XuNeo/stm8-led-display/hw/STM8-LED.pdf

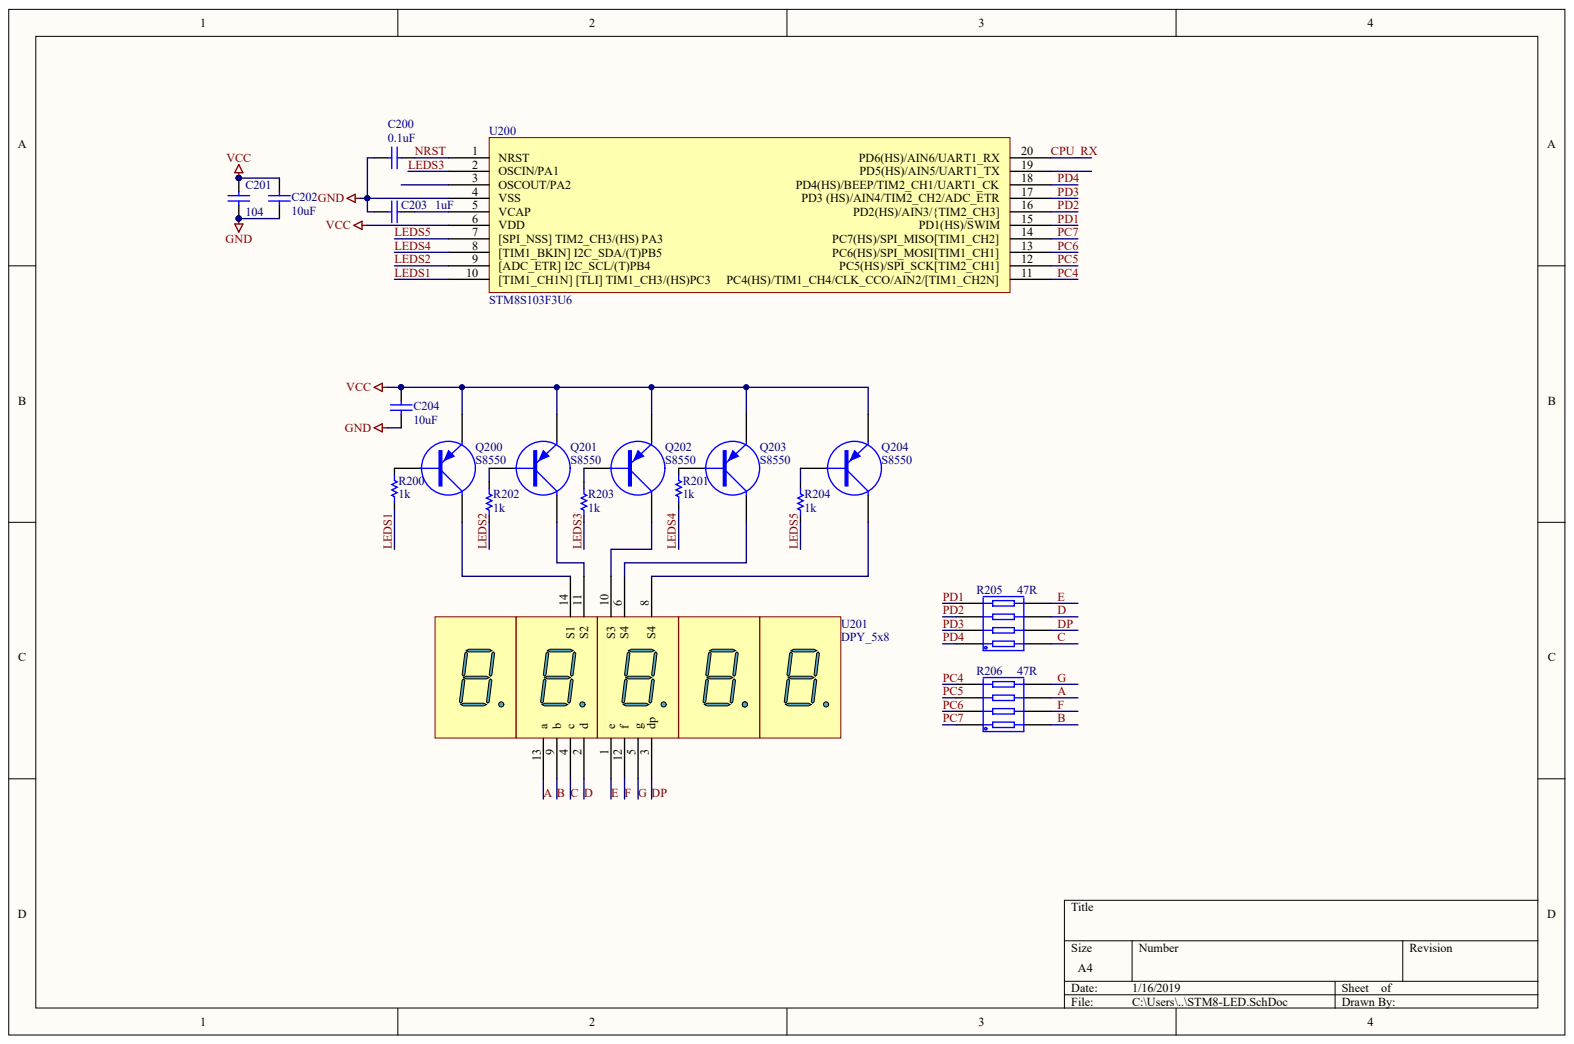
[picture p1: page 1]

Size A4 | Number | Revision

Date: 1/16/2019 | Sheet of
File: C:\Users\..\STM8-LED.SchDoc | Drawn By:

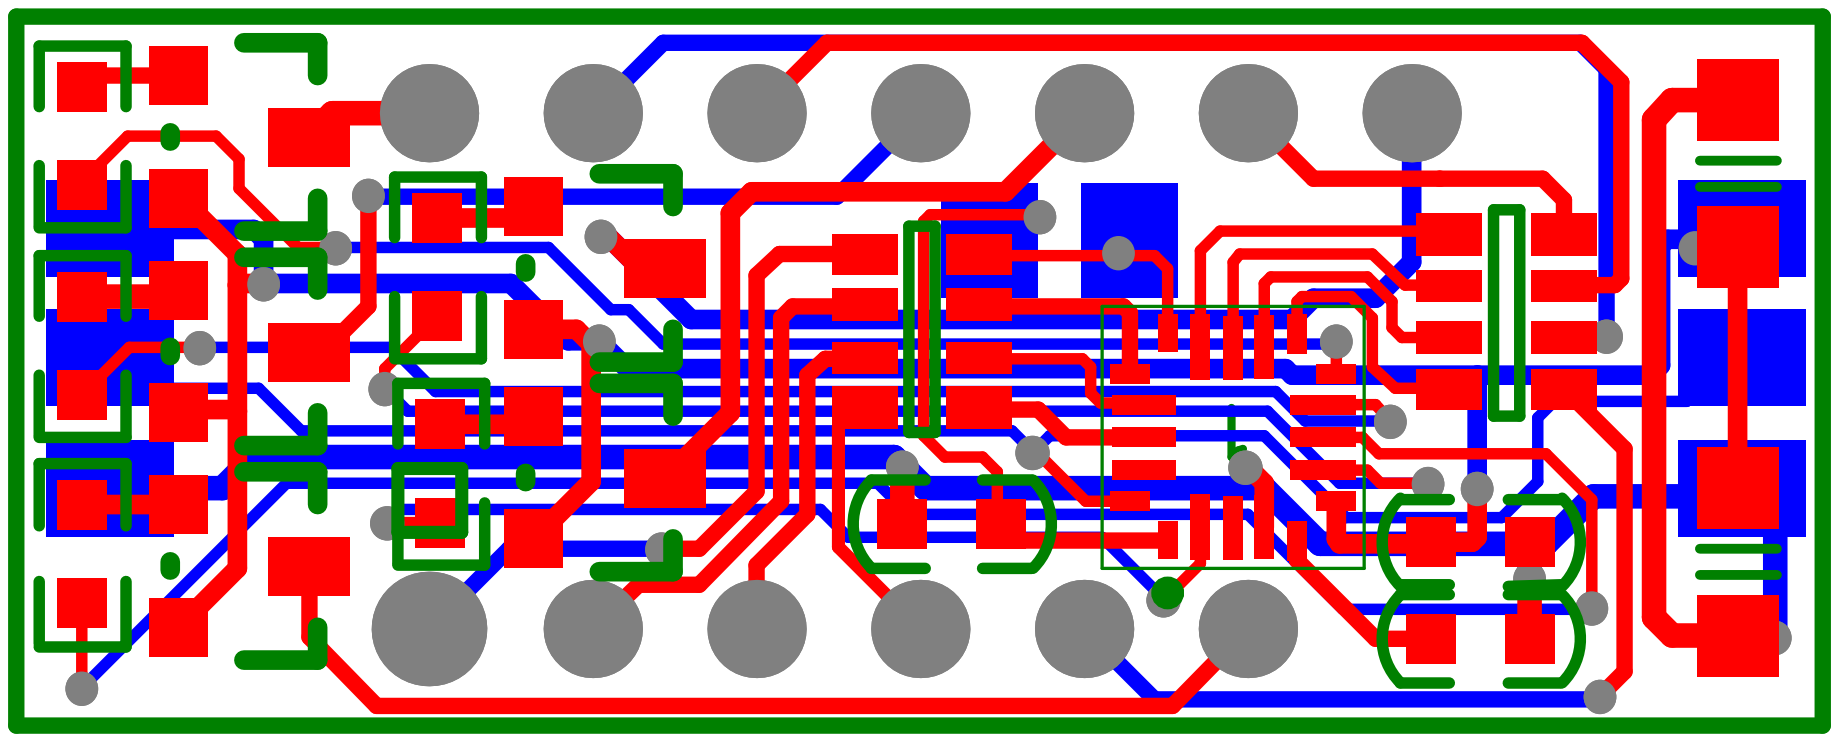
[picture p2: page 2]

Bill of Materials | <Parameter Title not found>
Source Data From: | STM8-LED.PrjPcb
Project: | | STM8-LED.PrjPcb
Variant: | | None
Creation Date: 1/16/2019 | 4:03:53 PM
Print Date: | 43481 | 43481.66941
Footprint | Comment | LibRef | Designator | Description | Quantity
C0603 | 0.1uF | CAP | C200 | Capacitor | 1
C0603 | 104 | CAP | C201 | Capacitor | 1
C0805 | 10uF | CAP | C202, C204 | Capacitor | 2
C0603 | 1uF | CAP | C203 | Capacitor | 1
sot-23 | S8550 | PNP_SOT23 | Q200, Q201, Q202, Q203, Q204 | PNP Transistor | 5
r0603 | 1k | RES1 | R200, R201, R202, R203, R204 | | 5
8P4R_0603 | 47R | Res Pack | R205, R206 | Isolated Resistor Network | 2
UFQFPN20_ 3X3X05P | STM8S103F3U6 | STM8S103F3U6 | U200 | STM8S103F3U6 | 1

# DPY_5X8-

0.23 | DPY_5x8 | DPY_5x8 | U201 | | 1
| | | | | 19
Approved | | Notes
