XuNeo/stm8-led-display/(commit log)

2018-12-15 fix usart pin settings. only enable rx, disable tx.
    [usart.c]
2019-01-15 add scroll feature. optimize led interface.
2019-01-16 add fifo to uart rx channel
2019-01-16 fix bug that led pbuff may overflow. restart sframe parser if reveivec unexpected SFRAM_STOP
    [ezled.c, serial_frame.c]
2019-01-16 add hardware schematic
2019-01-23 add contrast option for every led. blink contrast can be adjusted now. remove timer from led.c as stm8 is already too slow for refreshing
    [commands.c, ezled.c, ezled.h, led.c, led4.c, main.c, parameter.c, parameter.h]
2019-01-24 add license. Update command to set contrastA/B. Remove timer and loop as fast as possible
2019-01-27 reset scroll pos to start if new print available
    [ezled.c]
2019-01-28 add feature to highlight one led
2019-01-28 fix bug the flag hlight_en is not set
    [ezled.c]
2019-01-29 fix hlight-led bugs. Working now.
    [ezled.c, main.c, parameter.c]
2019-12-23 Update command set-highlight, use value \'maximum led bits\' to set all led to lowest contrast
2019-12-31 double buffering input string to avoid glitch
    [ezled.c]
